ndxw/InkSync/case/Test/Form_test.3mf

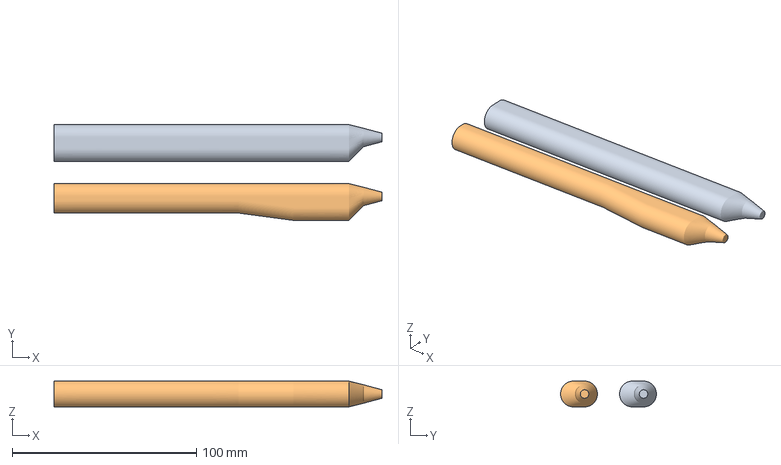
[picture p1: CAD file, 2025-03-25]
case/Test/Form_test.3mf
178.0 x 52.0 x 14.0 mm
Form_test_no_taper.stl
Form_test.stl
