ndxw/InkSync/case/Test/Form_test_no_taper.stl

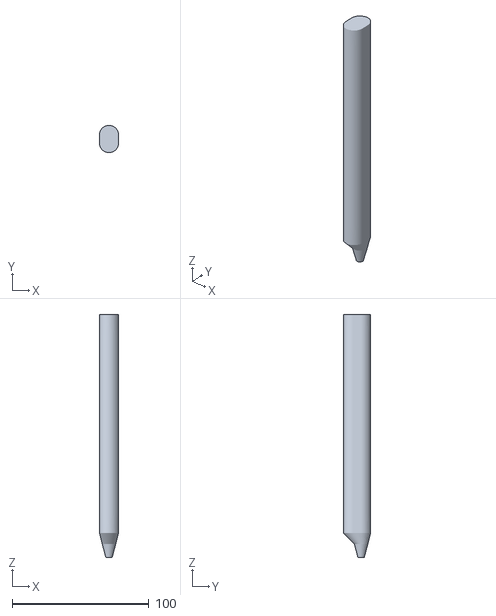
[picture p3: CAD file, 2025-03-22]
case/Test/Form_test_no_taper.stl
14.0 x 20.0 x 178.0
