ndxw/InkSync/(list of files, cad)

Other CAD files:
case/drawings/Shell_body_top.dwg
case/Sensor_PCB.dwg
case/drawings/Shell_body_bottom.dwg
case/drawings/Shell_tip.dwg
case/Battery.ipt
case/Charging_board.ipt
case/Display_stand/Display_stand.ipt
case/Enclosure.iam
case/Force_sensor.ipt
case/MCU_PCB.iam
case/MCU_PCB.ipt
case/OMGS3/(Unsaved).ipt
case/OMGS3/2450AT18B100E--3DModel-STEP-269445.iam
case/OMGS3/2450AT18B100E.ipt
case/OMGS3/C_0402_1005Metric.iam
case/OMGS3/C_0402_1005Metric.ipt
case/OMGS3/C_0603_1608Metric.iam
case/OMGS3/C_0603_1608Metric.ipt
case/OMGS3/D_SOD-523.iam
case/OMGS3/D_SOD_523.ipt
case/OMGS3/ESD7C5.0DT5G.ipt
case/OMGS3/ESP32-S2.ipt
case/OMGS3/ESP32_S2--3DModel-STEP-1.iam
case/OMGS3/LED_0402_1005Metric.iam
case/OMGS3/LED_0402_1005Metric.ipt
case/OMGS3/L_0402_1005Metric.iam
case/OMGS3/L_0402_1005Metric.ipt
case/OMGS3/MAX17048G+T10.ipt
case/OMGS3/MAX17048G-T10.iam
case/OMGS3/NCP160AMX280TBG.ipt
case/OMGS3/NCP170AMX170TCG.iam
case/OMGS3/OMGS3.iam
case/OMGS3/R_0402_1005Metric.iam
case/OMGS3/R_0402_1005Metric.ipt
case/OMGS3/SK6805-EC15.iam
case/OMGS3/SOT-723.iam
case/OMGS3/TDFN-6-1EP_2.5x2.5mm_P0.65mm_EP1.3x2mm.iam
case/OMGS3/TDFN_6_1EP_25x25mm_P065mm_EP13x2mm.ipt
case/OMGUSB.ipt
case/Optical_sensor.ipt
case/Pen_nib_stopper.ipt
case/Power_switch.ipt
case/Programming_jig/OMGS3_programming_jig.ipt
case/Sensor_PCB.iam
case/Sensor_PCB.ipt
case/Shell.ipt
case/Shell_body_bottom.ipt
case/Shell_body_top.ipt
case/Shell_tip.ipt
case/Sliding_switch.ipt
case/Spring_pin.ipt
case/Test/Form_test.ipt
case/Test/Form_test.stl
case/Test/Form_test_no_taper.ipt
