ndxw/InkSync/pcb/capstone_main_board/capstone_main_board.kicad_pcb

## KiCad design pcb/capstone_main_board/capstone_main_board.kicad_pcb (2025-03-22)

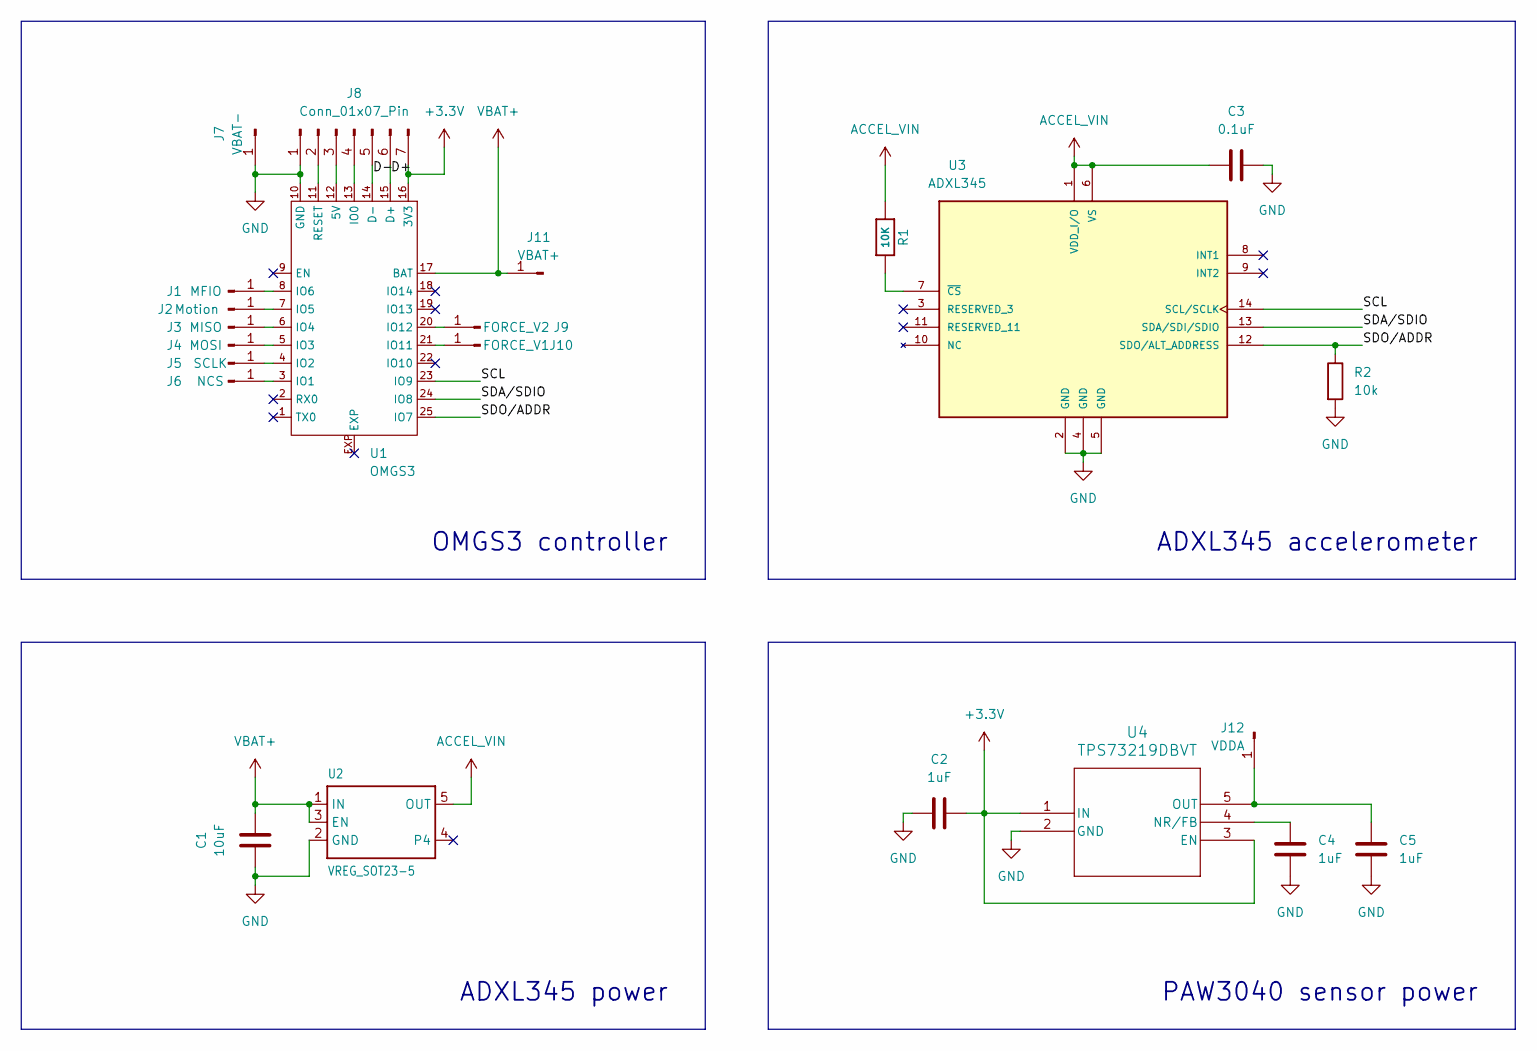
[picture p4: schematic capstone_main_board.kicad_sch]

Parts:
C1: 10uF; C_0805_2012Metric
C2, C4, C5: 1uF; C_0603_1608Metric
C3: 0.1uF; C_0402_1005Metric
J1: MFIO; PinHeader_1x01_P2.00mm_Vertical
J2: Motion; PinHeader_1x01_P2.00mm_Vertical
J3: MISO; PinHeader_1x01_P2.00mm_Vertical
J4: MOSI; PinHeader_1x01_P2.00mm_Vertical
J5: SCLK; PinHeader_1x01_P2.00mm_Vertical
J6: NCS; PinHeader_1x01_P2.00mm_Vertical
J7: VBAT-; PinHeader_1x01_P2.00mm_Vertical
J8: Conn_01x07_Pin; OMGS3_programming_pins
J9: FORCE_V2; PinHeader_1x01_P2.00mm_Vertical
J10: FORCE_V1; PinHeader_1x01_P2.00mm_Vertical
J11: VBAT+; PinHeader_1x01_P2.00mm_Vertical
J12: VDDA; PinHeader_1x01_P2.00mm_Vertical
R1: 10K; R_0402_1005Metric
R2: 10k; R_0402_1005Metric
U1: OMGS3
U2: VREG_SOT23-5; SOT95P280X145-5N
U3: ADXL345; PQFN80P500X300X100-14N; PARTREV B
U4: TPS73219DBVT; DBV5_TEX

Connections:
+3.3V: C2.1, J8.7, U1.16 (3V3), U4.1 (IN), U4.3 (EN)
/D+: J8.6, U1.15 (D+)
/D-: J8.5, U1.14 (D-)
/SCL: U1.23 (IO9), U3.14 (SCL/SCLK)
/SDA/SDIO: U1.24 (IO8), U3.13 (SDA/SDI/SDIO)
/SDO/ADDR: R2.1, U1.25 (IO7), U3.12 (SDO/ALT_ADDRESS)
ACCEL_VIN: C3.2, R1.2, U2.5 (OUT), U3.1 (VDD_I/O), U3.6 (VS)
GND: C1.1, C2.2, C3.1, C4.2, C5.2, J7.1, J8.1, R2.2, U1.10 (GND), U2.2 (GND), U3.2 (GND), U3.4 (GND), U3.5 (GND), U4.2 (GND)
unnamed: J1.1, U1.8 (IO6)
unnamed: J2.1, U1.7 (IO5)
unnamed: J3.1, U1.6 (IO4)
unnamed: J4.1, U1.5 (IO3)
unnamed: J5.1, U1.4 (IO2)
unnamed: J6.1, U1.3 (IO1)
unnamed: J8.2, U1.11 (RESET)
unnamed: J8.3, U1.12 (5V)
unnamed: J8.4, U1.13 (IO0)
unnamed: J9.1, U1.20 (IO12)
unnamed: J10.1, U1.21 (IO11)
unnamed: C5.1, J12.1, U4.5 (OUT)
unnamed: R1.1, U3.7 (~CS)
unnamed: C4.1, U4.4 (NR/FB)
VBAT+: C1.2, J11.1, U1.17 (BAT), U2.1 (IN), U2.3 (EN)

Notes on the sheet:
PAW3040 sensor power
OMGS3 controller
ADXL345 accelerometer
ADXL345 power

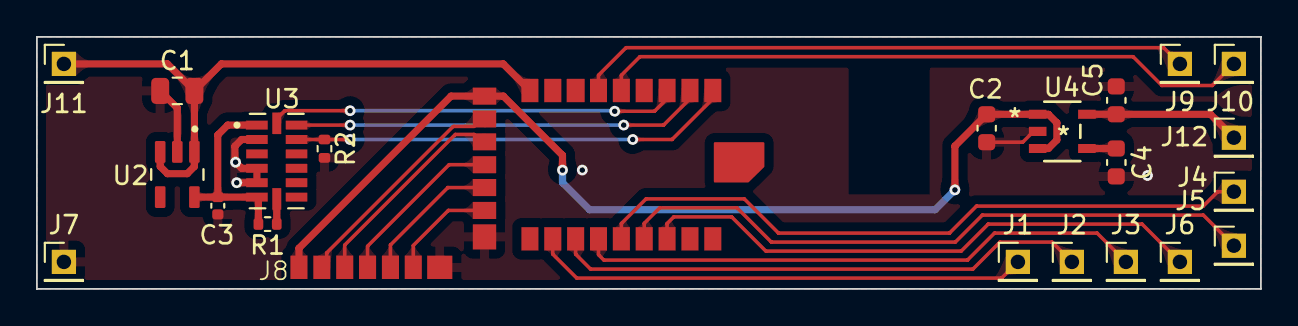
[picture p5: board capstone_main_board.kicad_pcb from above]

Board: 2 copper layers, 68.0 x 14.0 mm, 23 parts (0 on the bottom side), 23 nets.
