ndxw/InkSync/pcb/capstone_v2/capstone_v2.kicad_pcb

## KiCad design pcb/capstone_v2/capstone_v2.kicad_pcb (2025-03-22)

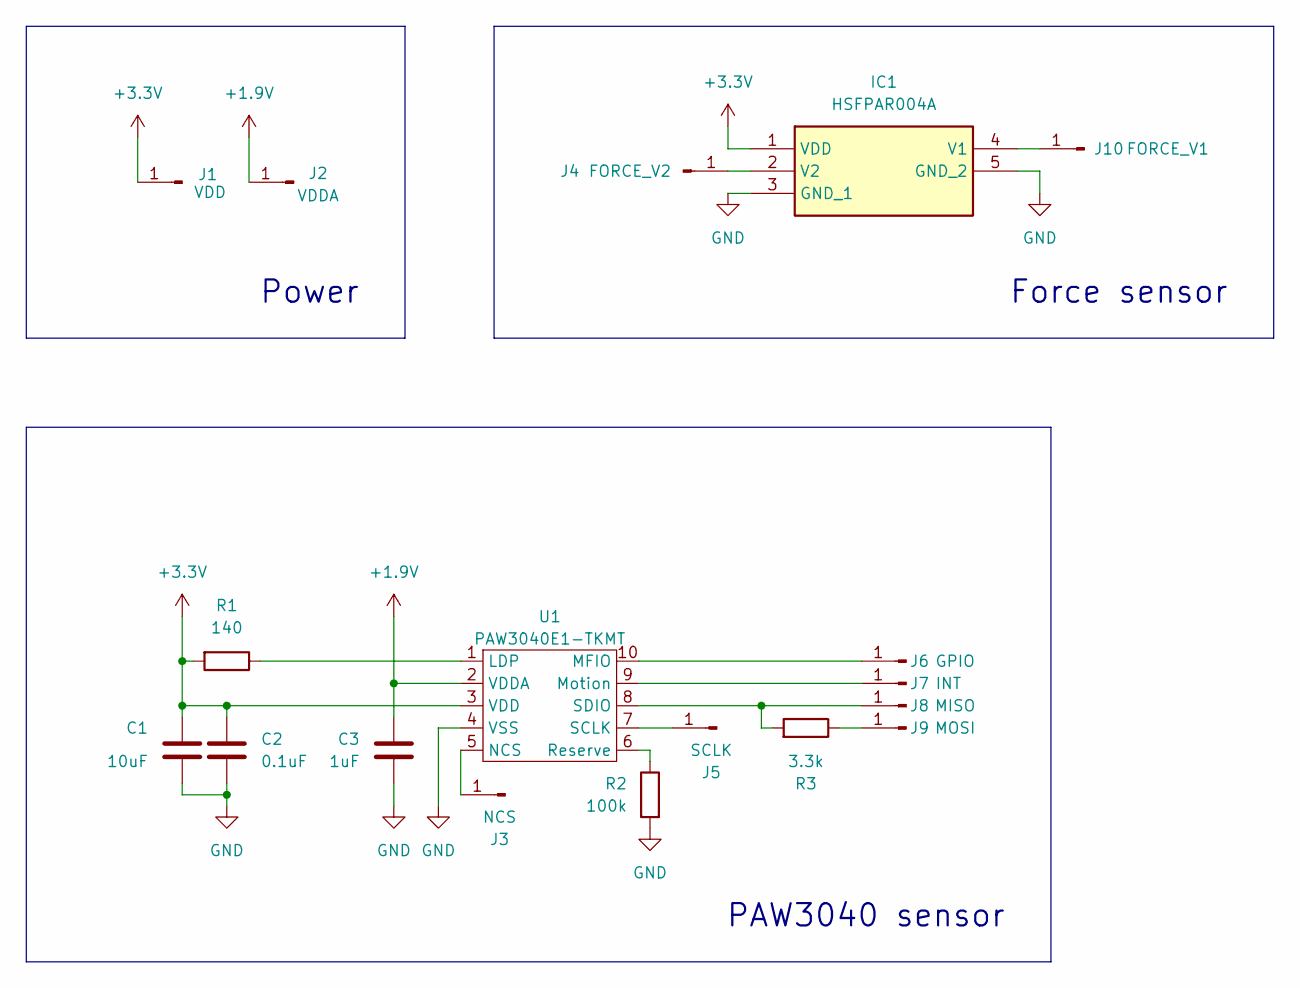
[picture p6: schematic capstone_v2.kicad_sch]

Parts:
C1: 10uF; C_0805_2012Metric
C2: 0.1uF; C_0402_1005Metric
C3: 1uF; C_0603_1608Metric
IC1: HSFPAR004A; Mouser Part Number 688-HSFPAR004A
J1: VDD; PinHeader_1x01_P1.00mm_Vertical
J2: VDDA; PinHeader_1x01_P1.00mm_Vertical
J3: NCS; PinHeader_1x01_P1.00mm_Vertical
J4: FORCE_V2; PinHeader_1x01_P1.00mm_Vertical
J5: SCLK; PinHeader_1x01_P1.00mm_Vertical
J6: GPIO; PinHeader_1x01_P1.00mm_Vertical
J7: INT; PinHeader_1x01_P1.00mm_Vertical
J8: MISO; PinHeader_1x01_P1.00mm_Vertical
J9: MOSI; PinHeader_1x01_P1.00mm_Vertical
J10: FORCE_V1; PinHeader_1x01_P1.00mm_Vertical
R1: 140; R_0603_1608Metric
R2: 100k; R_0603_1608Metric
R3: 3.3k; R_0402_1005Metric
U1: PAW3040E1-TKMT

Connections:
+1.9V: C3.1, J2.1, U1.2 (VDDA)
+3.3V: C1.1, C2.1, IC1.1 (VDD), J1.1, R1.2, U1.3 (VDD)
GND: C1.2, C2.2, C3.2, IC1.3 (GND_1), IC1.5 (GND_2), R2.2, U1.4 (VSS)
unnamed: IC1.4 (V1), J10.1
unnamed: IC1.2 (V2), J4.1
unnamed: J3.1, U1.5 (NCS)
unnamed: J5.1, U1.7 (SCLK)
unnamed: J6.1, U1.10 (MFIO)
unnamed: J7.1, U1.9 (Motion)
unnamed: J8.1, R3.2, U1.8 (SDIO)
unnamed: J9.1, R3.1
unnamed: R1.1, U1.1 (LDP)
unnamed: R2.1, U1.6 (Reserve)

Notes on the sheet:
PAW3040 sensor
Force sensor
Power

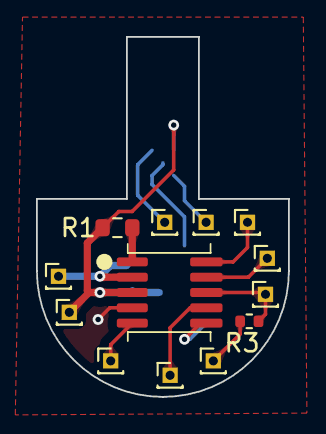
[picture p7: board capstone_v2.kicad_pcb from above]

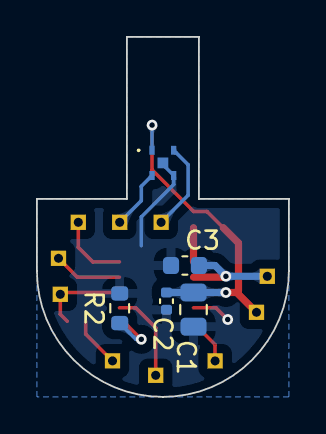
[picture p8: board capstone_v2.kicad_pcb from below]

Board: 2 copper layers, 14.0 x 20.0 mm, 18 parts (5 on the bottom side), 13 nets.
