ndxw/InkSync/pcb/PCB_Capstone_prototype_1_optical_S/PCB_Capstone_prototype_1_optical_S.kicad_pcb

## KiCad design pcb/PCB_Capstone_prototype_1_optical_S/PCB_Capstone_prototype_1_optical_S.kicad_pcb (2025-01-14)

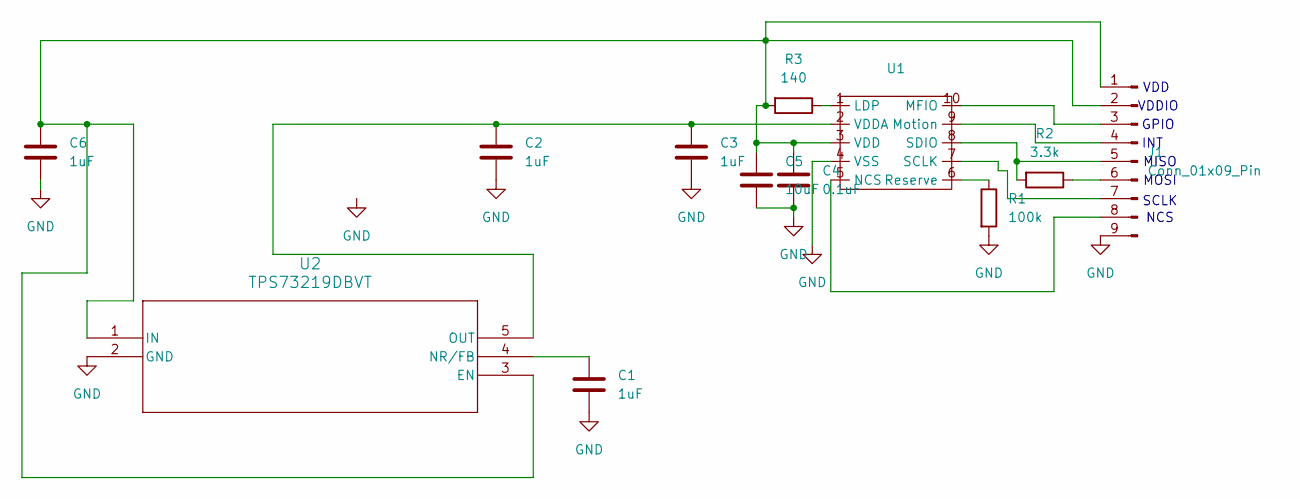
[picture p9: schematic PCB_Capstone_prototype_1_optical_S.kicad_sch]

Parts:
C1, C2, C3, C6: 1uF; CAP_CL10_SAM
C4: 0.1uF; CAP_CL05_SAM
C5: 10uF; CAP_CL21_SAM
J1: Conn_01x09_Pin; PinHeader_1x09_P1.00mm_Vertical
R1: 100k; RC0603N_PAN
R2: 3.3k; RC0603N_PAN
R3: 140; RC0603N_PAN
U1: Optical_Sensor
U2: TPS73219DBVT; DBV5_TEX

Connections:
GND: C1.2, C2.2, C3.2, C4.2, C5.2, C6.2, J1.9, R1.2, U1.4 (VSS), U2.2 (GND)
unnamed: C4.1, C5.1, C6.1, J1.1, J1.2, R3.2, U1.3 (VDD), U2.1 (IN), U2.3 (EN)
unnamed: J1.3, U1.10 (MFIO)
unnamed: J1.4, U1.9 (Motion)
unnamed: J1.5, R2.2, U1.8 (SDIO)
unnamed: J1.6, R2.1
unnamed: J1.7, U1.7 (SCLK)
unnamed: J1.8, U1.5 (NCS)
unnamed: R3.1, U1.1 (LDP)
unnamed: R1.1, U1.6 (Reserve)
unnamed: C2.1, C3.1, U1.2 (VDDA), U2.5 (OUT)
unnamed: C1.1, U2.4 (NR/FB)

Notes on the sheet:
SCLK
MISO
INT
VDD
MOSI
NCS
VDDIO
GPIO

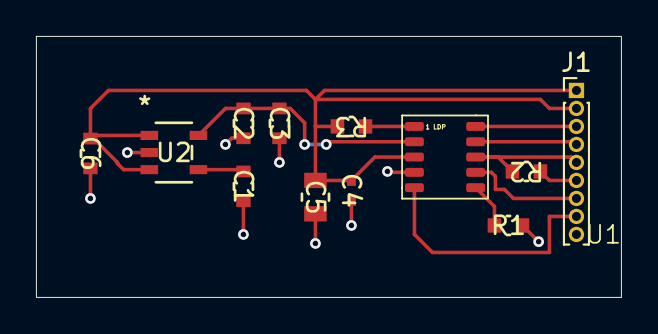
[picture p10: board PCB_Capstone_prototype_1_optical_S.kicad_pcb from above]

Board: 2 copper layers, 32.5 x 14.5 mm, 12 parts (0 on the bottom side), 12 nets.
