ndxw/InkSync/src/main/define.h

#define BANK_SWITCH 0x7F

#define PRODUCT_ID1 0x00
#define PRODUCT_ID2 0x01
#define MOTION_STATUS 0x02
#define DELTA_XL 0x03
#define DELTA_YL 0x04
#define CONFIGURATION 0x06
#define WRITE_PROTECT 0x09
#define RES_X 0x0D
#define RES_Y 0x0E
#define DELTA_XH 0x11
#define DELTA_YH 0x12
#define IQ 0x13
#define SHUTTER 0x15
#define FRAMEAVG 0x17
#define MFIO_CONFIG 0x26
#define LD_SRC 0x51 
