ndxw/InkSync/(commit log)

2025-01-12 Uploaded design files for optical sensor
2025-01-14 unzipped pcb
    [PCB_Capstone_prototype_1_optical_S-B_Cu.gbr, PCB_Capstone_prototype_1_optical_S-B_Mask.gbr, PCB_Capstone_prototype_1_optical_S-B_Paste.gbr, PCB_Capstone_prototype_1_optical_S-B_Silkscreen.gbr, PCB_Capstone_prototype_1_optical_S-Edge_Cuts.gbr, PCB_Capstone_prototype_1_optical_S-F_Cu.gbr, PCB_Capstone_prototype_1_optical_S-F_Mask.gbr, PCB_Capstone_prototype_1_optical_S-F_Paste.gbr]
2025-02-03 attempting SPI communication
2025-02-08 debug using SPI bitbanging
2025-02-14 successful read from all three sensors
2025-03-15 sensor and mcu board v1
    [capstone_main_board-B_Cu.gbr, capstone_main_board-B_Mask.gbr, capstone_main_board-B_Paste.gbr, capstone_main_board-B_Silkscreen.gbr, capstone_main_board-Edge_Cuts.gbr, capstone_main_board-F_Cu.gbr, capstone_main_board-F_Mask.gbr, capstone_main_board-F_Paste.gbr]
2025-03-16 sensor and mcu board nearly complete
    [capstone_main_board-B_Cu.gbr, capstone_main_board-B_Mask.gbr, capstone_main_board-B_Paste.gbr, capstone_main_board-B_Silkscreen.gbr, capstone_main_board-Edge_Cuts.gbr, capstone_main_board-F_Cu.gbr, capstone_main_board-F_Mask.gbr, capstone_main_board-F_Paste.gbr]
2025-03-16 removed irrelevant kicad projects
    [PCB_Capstone_prototype_1_optical_S-B_Cu.gbr, PCB_Capstone_prototype_1_optical_S-B_Mask.gbr, PCB_Capstone_prototype_1_optical_S-B_Paste.gbr, PCB_Capstone_prototype_1_optical_S-B_Silkscreen.gbr, PCB_Capstone_prototype_1_optical_S-Edge_Cuts.gbr, PCB_Capstone_prototype_1_optical_S-F_Cu.gbr, PCB_Capstone_prototype_1_optical_S-F_Mask.gbr, PCB_Capstone_prototype_1_optical_S-F_Paste.gbr]
2025-03-16 added teardrops
    [capstone_main_board.kicad_pcb, capstone_main_board.kicad_sch, capstone_v2.kicad_pcb]
2025-03-22 enclosure main body complete
    [Battery.ipt, Charging_board.ipt, Enclosure.0002.iam, Enclosure.iam, Force_sensor.0005.ipt, Form_test.3mf, Form_test.ipt, Form_test.stl]
2025-03-25 optical sensor done
2025-03-25 programming jig
    [Form_test.3mf, OMGS3_programming_jig.3mf, OMGS3_programming_jig.ipt, OMGS3_programming_jig.stl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]
2025-03-25 initial shell design
    [Enclosure.iam, MCU_PCB.iam, MCU_PCB.ipt, OMGS3_programming_jig.3mf, OMGS3_programming_jig.stl, Pen_nib_stopper.ipt, Power_switch.ipt, Sensor_PCB.iam]
2025-03-26 completed enclosure top half
    [Enclosure.iam, Pen_nib_stopper.ipt, Power_switch.ipt, Sensor_PCB.iam, Shell.ipt, Shell_body_bottom.ipt, Shell_body_top.ipt, Shell_tip.ipt]
2025-03-30 force sensor test
2025-04-03 Fixed pressure and absolute movement
    [BLEMouseCustom.cpp, BLEMouseCustom.h, main.ino]
2025-04-20 created drawings for report
    [Display_stand.ipt, Enclosure.iam, Force_sensor.ipt, MCU_PCB.iam, MCU_PCB.ipt, OMGS3.iam, OMGUSB.ipt, Optical_sensor.ipt]
